myhumankit/ReadForMe/documentation/images/rfm_boitier_test.JPG

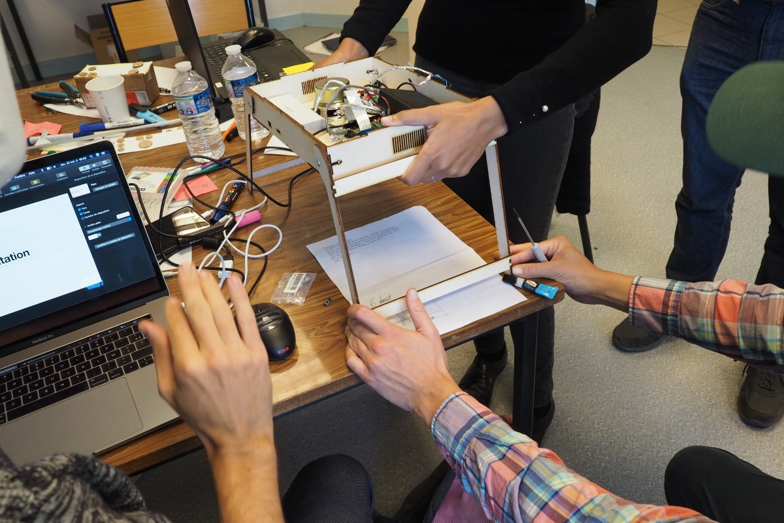
documentation/images/rfm_boitier_test.JPG
