myhumankit/ReadForMe/documentation/images/rfm_proto_carton_test.JPG

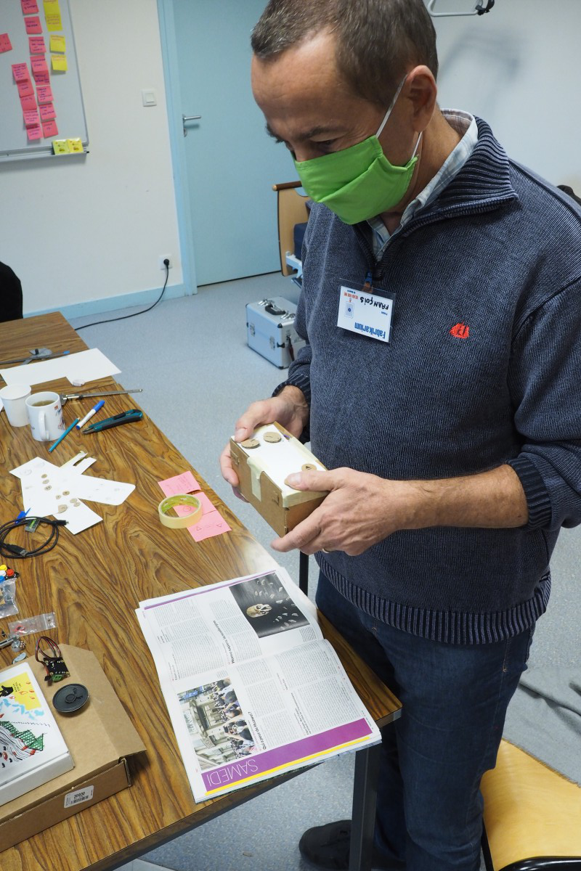
documentation/images/rfm_proto_carton_test.JPG
