myhumankit/ReadForMe/documentation/dessin/images/GPIO_2.png

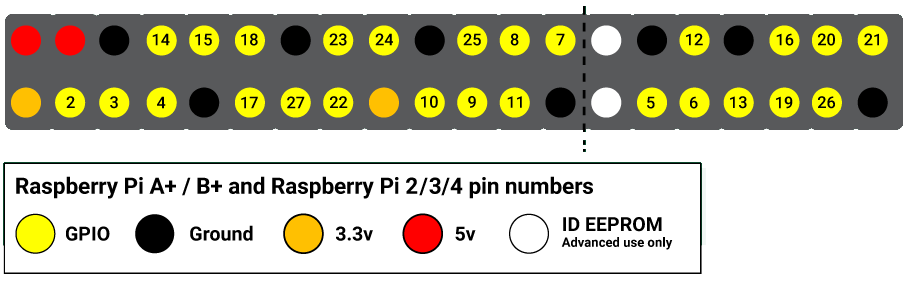
documentation/dessin/images/GPIO_2.png
