myhumankit/ReadForMe/documentation/dessin/images/potentiometer.png

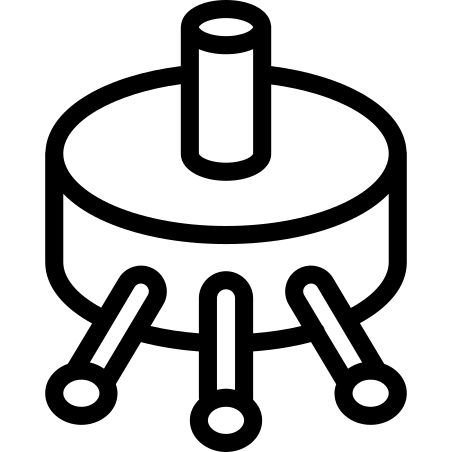
documentation/dessin/images/potentiometer.png
