myhumankit/ReadForMe/documentation/dessin/images/rasp.png

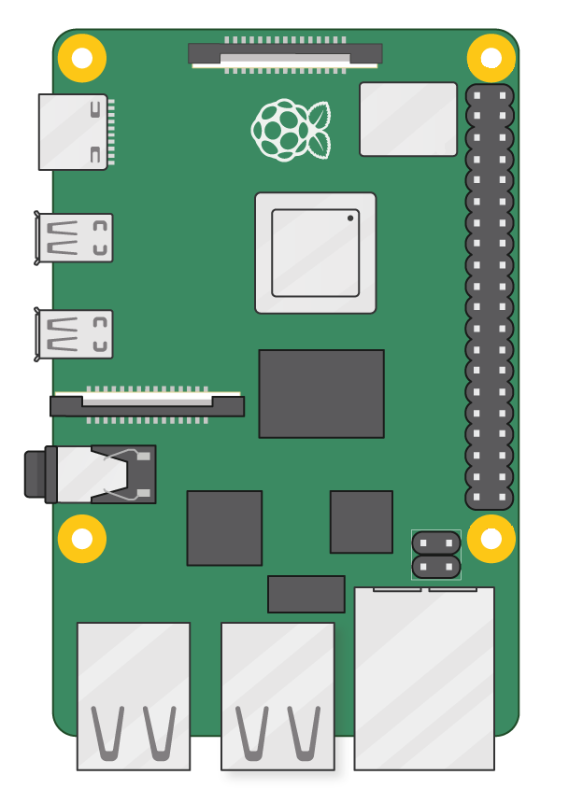
documentation/dessin/images/rasp.png
