myhumankit/ReadForMe/documentation/images/rfm_anim_1.gif

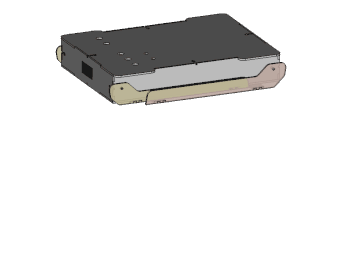
documentation/images/rfm_anim_1.gif
