myhumankit/ReadForMe/documentation/images/rfm_anim_2.gif

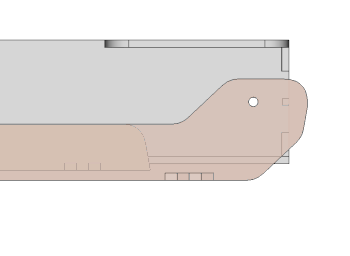
documentation/images/rfm_anim_2.gif
