myhumankit/ReadForMe/documentation/images/rfm_blaze.jpg

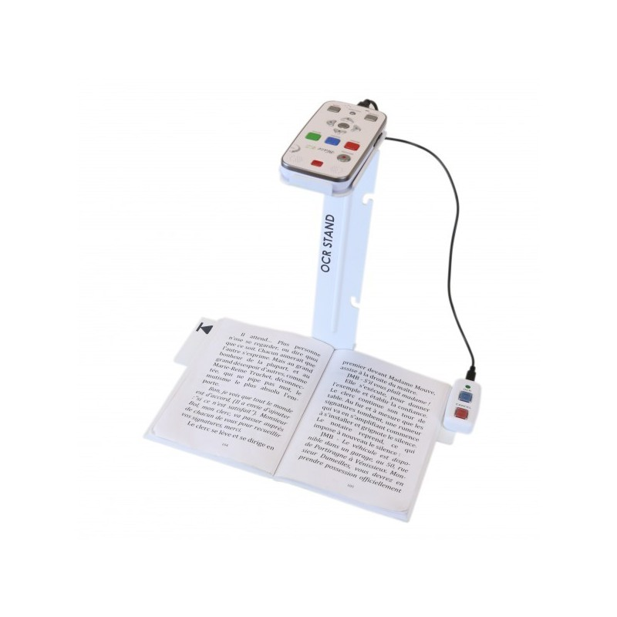
documentation/images/rfm_blaze.jpg
