myhumankit/ReadForMe/documentation/images/rfm_boitier_aluminium.jpg

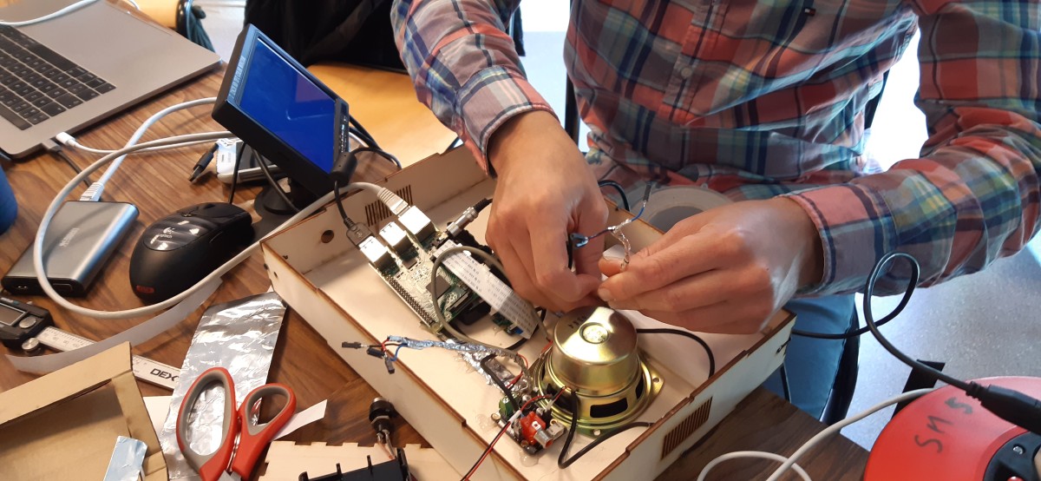
documentation/images/rfm_boitier_aluminium.jpg
