myhumankit/ReadForMe/documentation/images/rfm_boitier_boutons.JPG

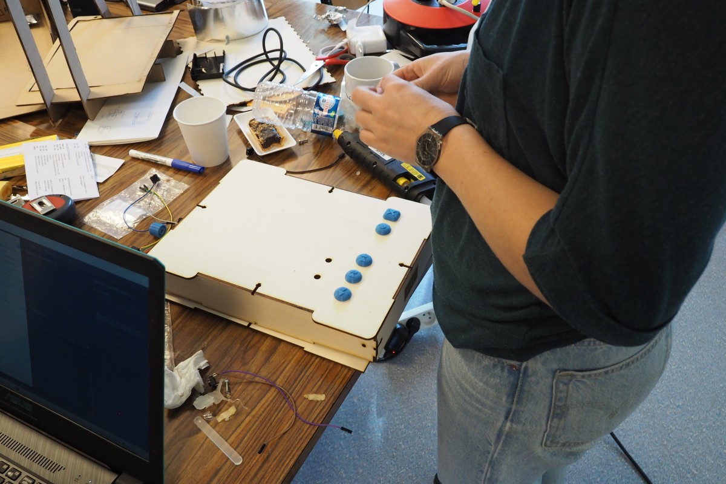
documentation/images/rfm_boitier_boutons.JPG
