myhumankit/ReadForMe/documentation/images/rfm_boitier_colle.JPG

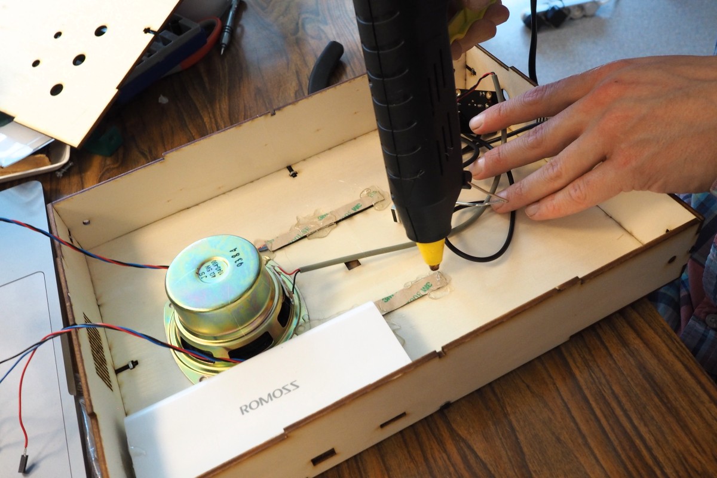
documentation/images/rfm_boitier_colle.JPG
