myhumankit/ReadForMe/documentation/images/rfm_boitier_interieur.JPG

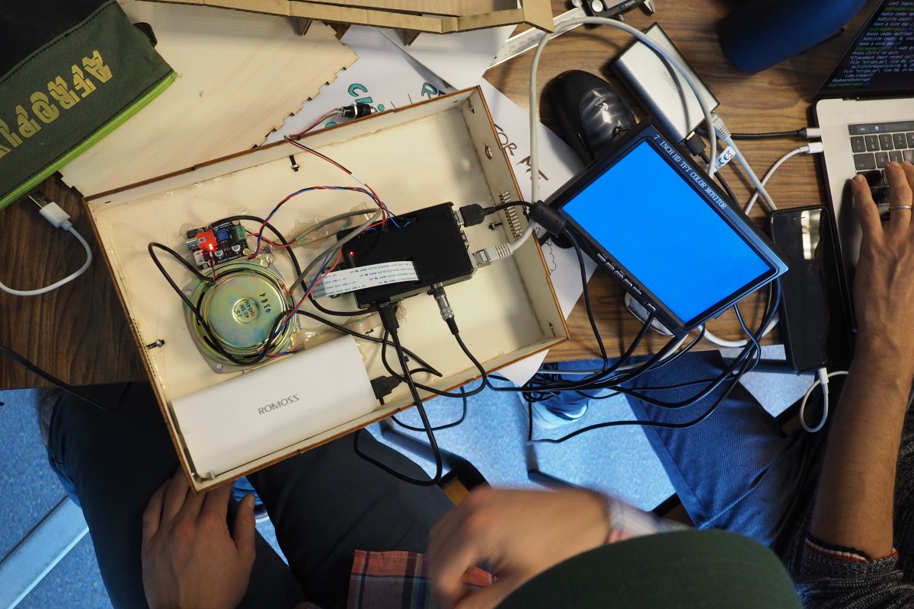
documentation/images/rfm_boitier_interieur.JPG
