myhumankit/ReadForMe/documentation/images/rfm_boutons.png

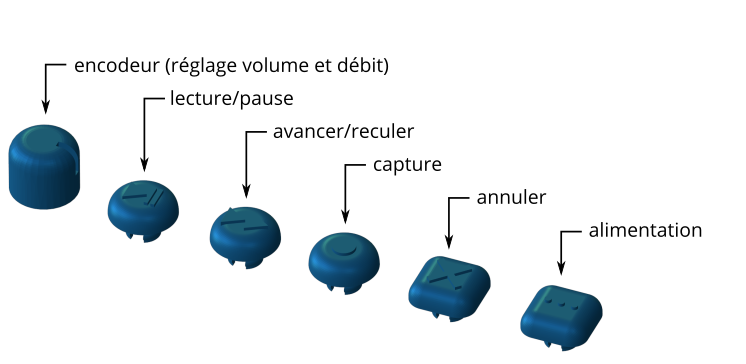
documentation/images/rfm_boutons.png
