myhumankit/ReadForMe/documentation/images/rfm_cablageampli.JPG

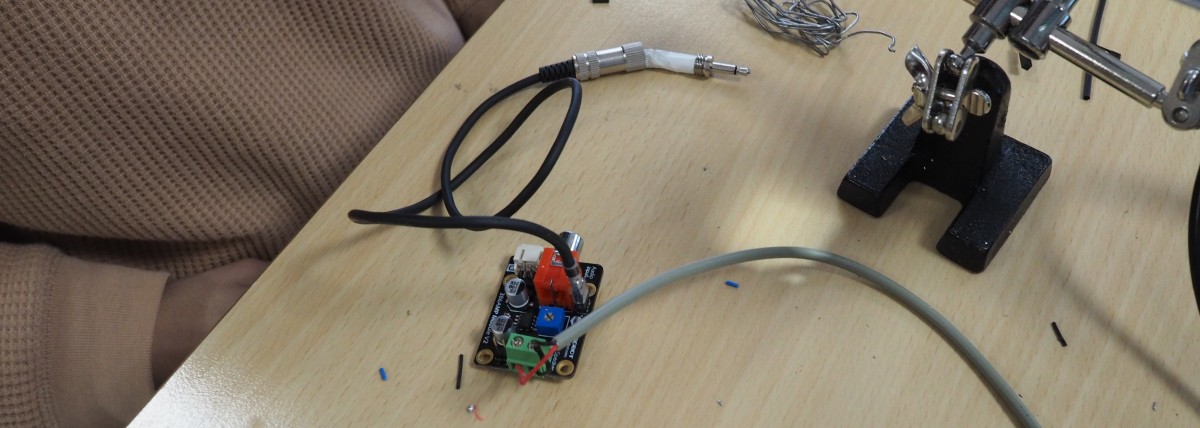
documentation/images/rfm_cablageampli.JPG
