myhumankit/ReadForMe/documentation/images/rfm_circuit.png

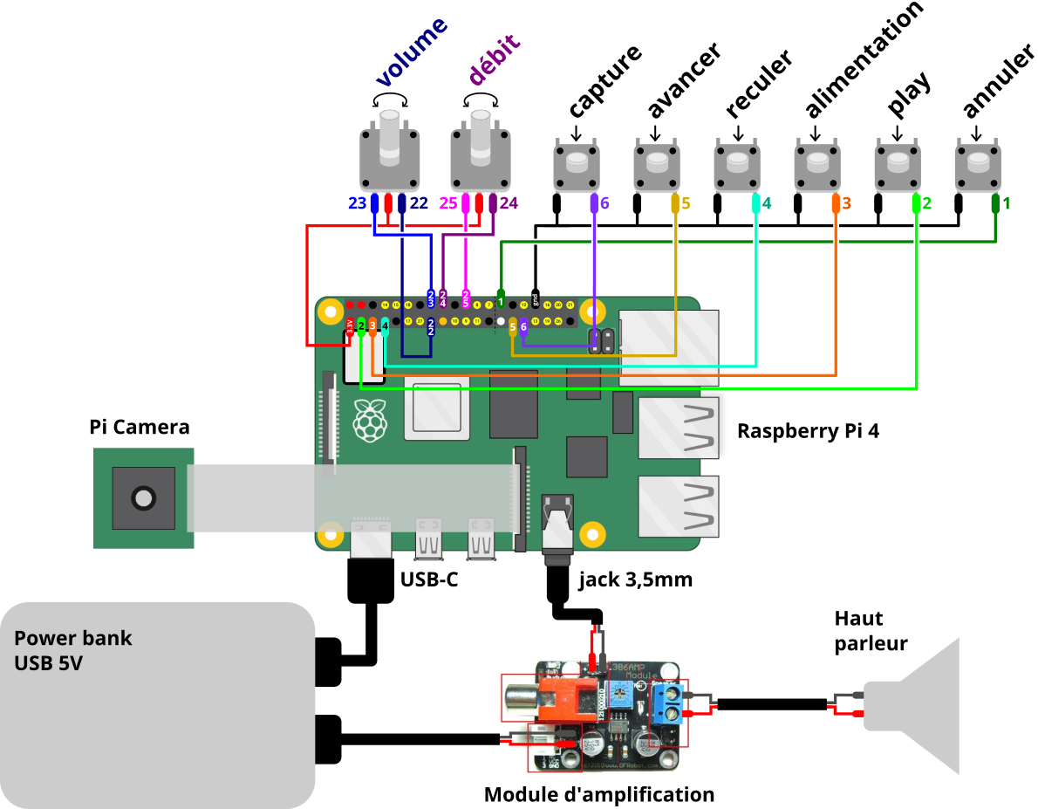
documentation/images/rfm_circuit.png
