myhumankit/ReadForMe/documentation/images/rfm_circuit_pi.JPG

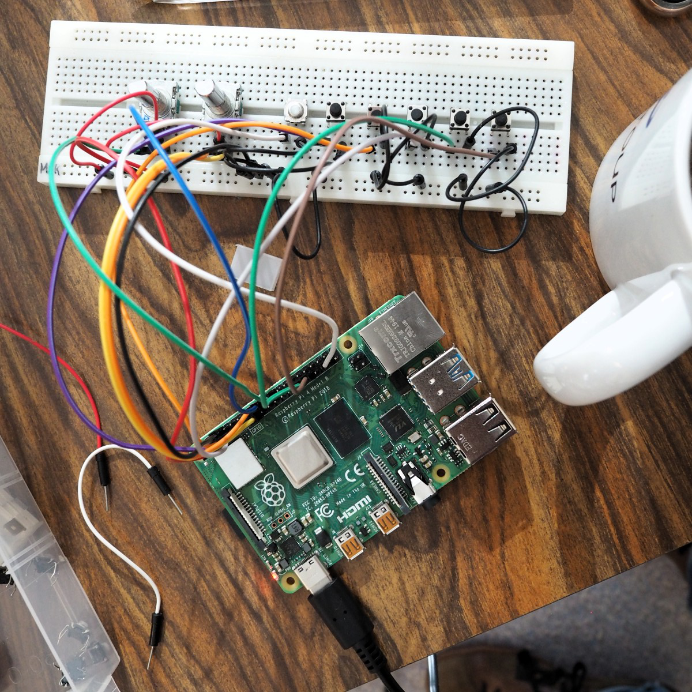
documentation/images/rfm_circuit_pi.JPG
