myhumankit/ReadForMe/documentation/images/rfm_decoupe.png

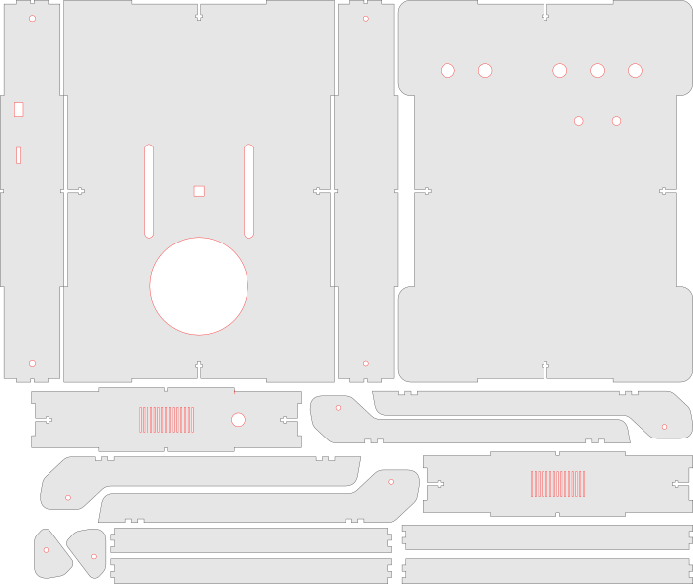
documentation/images/rfm_decoupe.png
