myhumankit/ReadForMe/documentation/images/rfm_design_boutons.JPG

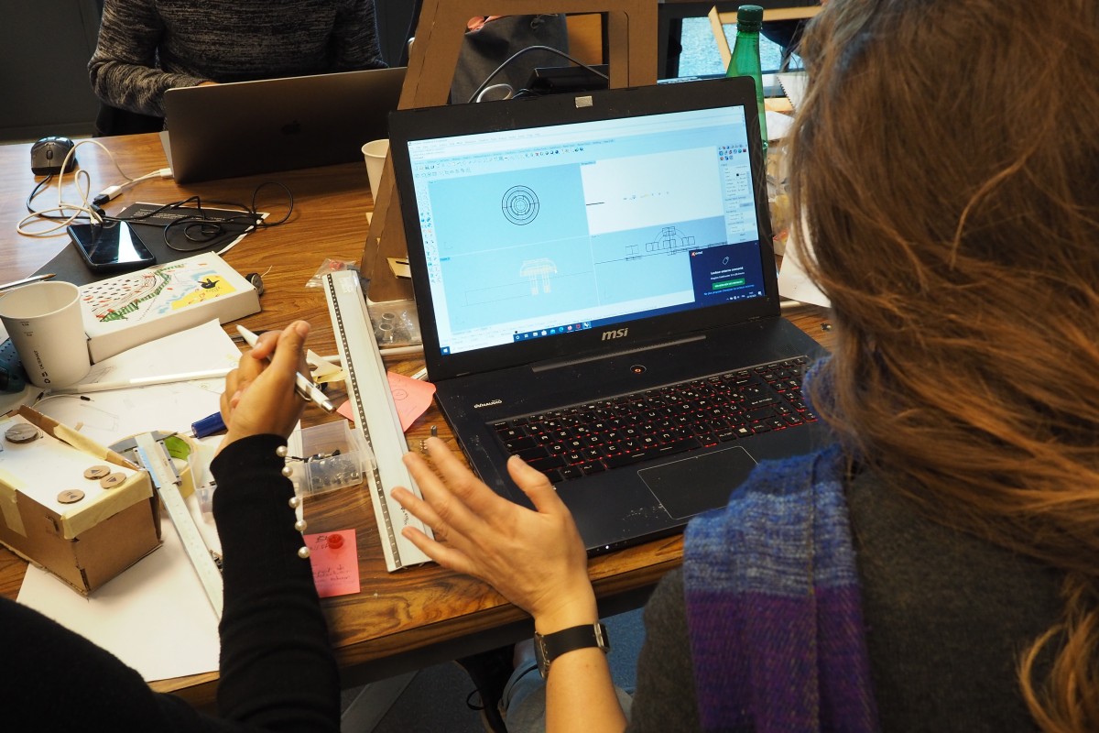
documentation/images/rfm_design_boutons.JPG
