myhumankit/ReadForMe/documentation/images/rfm_equipe0.JPG

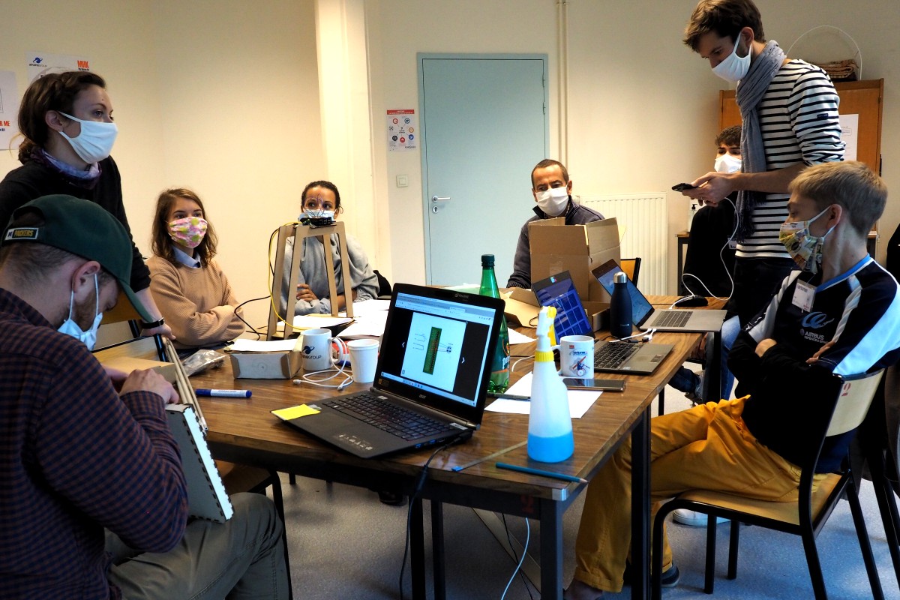
documentation/images/rfm_equipe0.JPG
