myhumankit/ReadForMe/documentation/images/rfm_equipe1.JPG

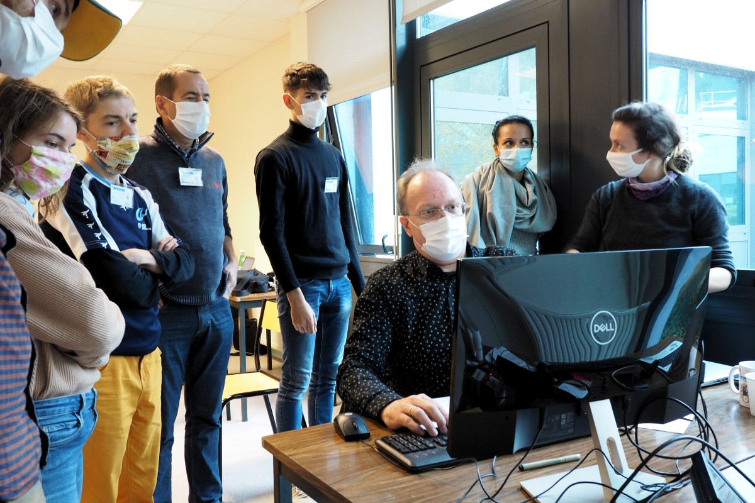
documentation/images/rfm_equipe1.JPG
