myhumankit/ReadForMe/documentation/images/rfm_gpio.png

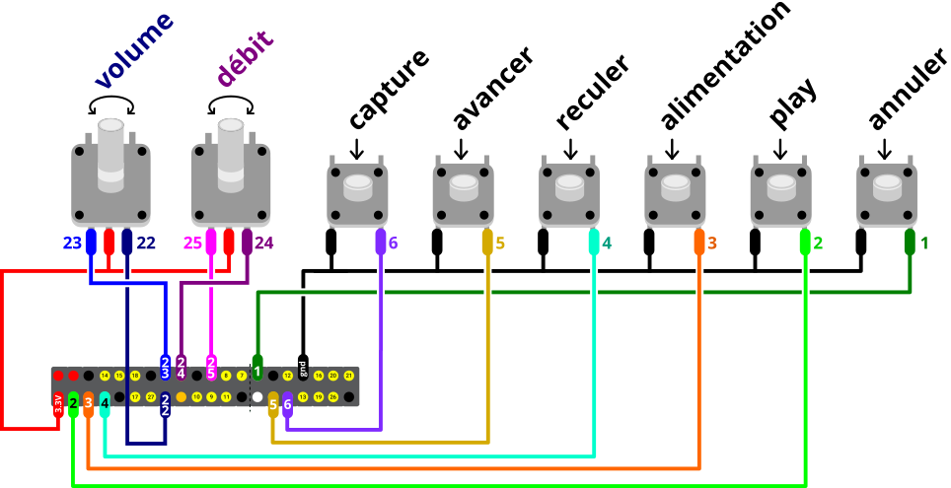
documentation/images/rfm_gpio.png
