myhumankit/ReadForMe/documentation/images/rfm_pitextreader.JPG

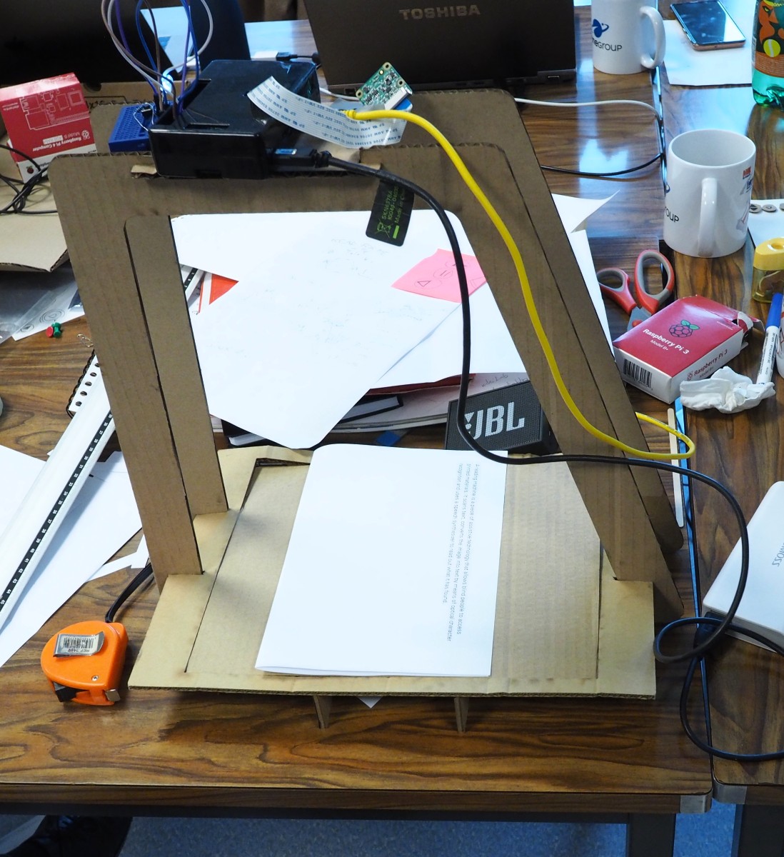
documentation/images/rfm_pitextreader.JPG
