myhumankit/ReadForMe/documentation/images/rfm_polissage.JPG

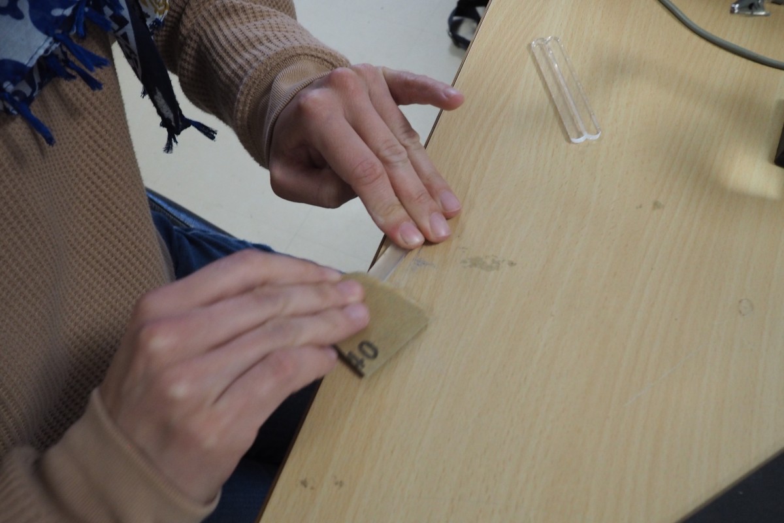
documentation/images/rfm_polissage.JPG
