myhumankit/ReadForMe/documentation/images/rfm_principe_2.png

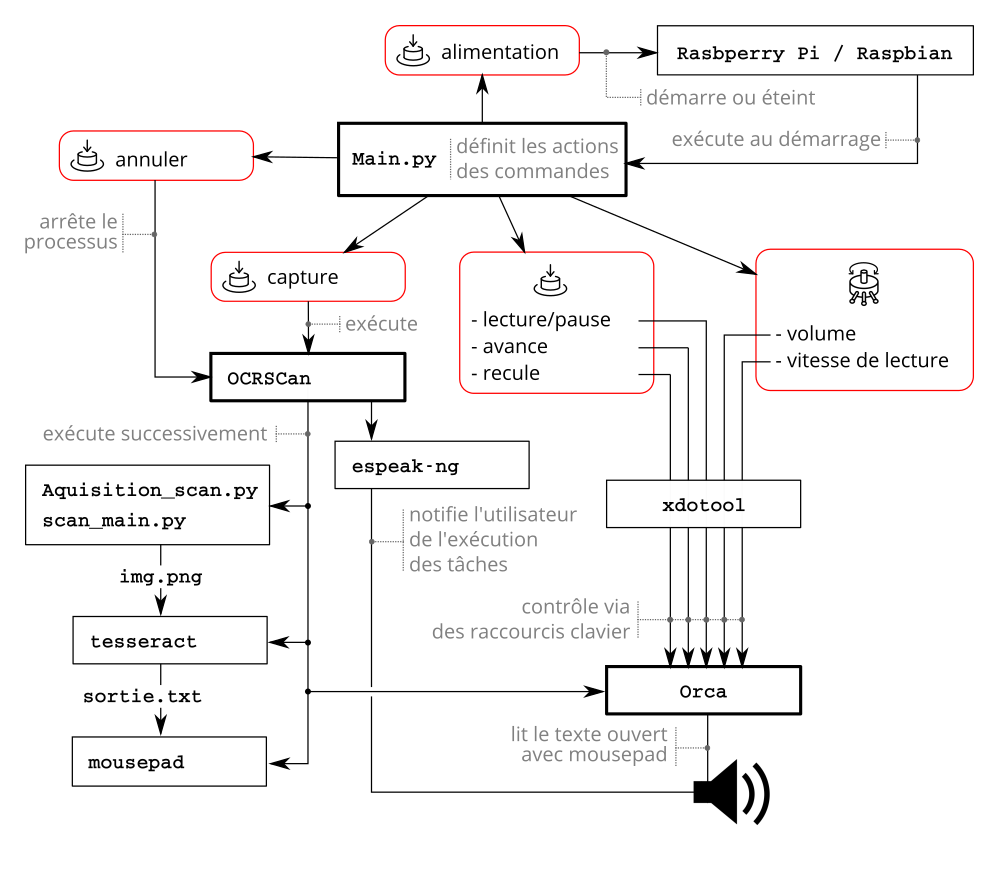
documentation/images/rfm_principe_2.png
