myhumankit/ReadForMe/documentation/images/rfm_proto_carton1.JPG

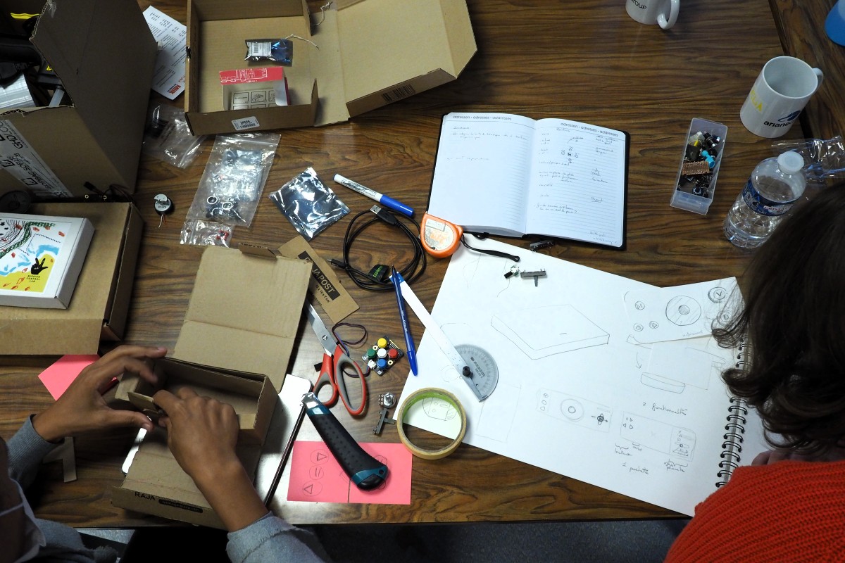
documentation/images/rfm_proto_carton1.JPG
