myhumankit/ReadForMe/documentation/images/rfm_proto_carton2.JPG

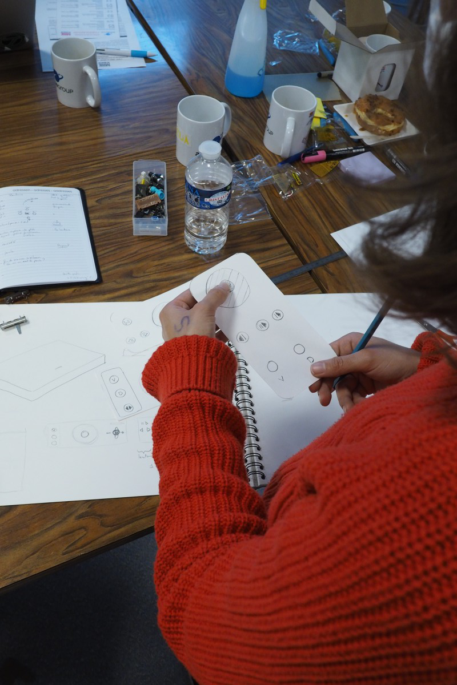
documentation/images/rfm_proto_carton2.JPG
