myhumankit/ReadForMe/documentation/images/rfm_proto_circuit.jpg

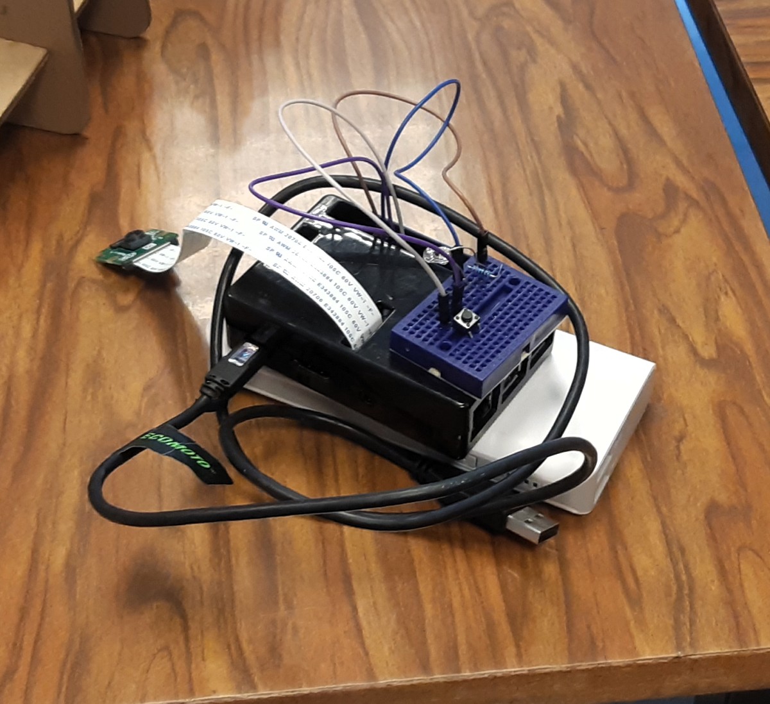
documentation/images/rfm_proto_circuit.jpg
