myhumankit/ReadForMe/documentation/images/rfm_vocatex.jpg

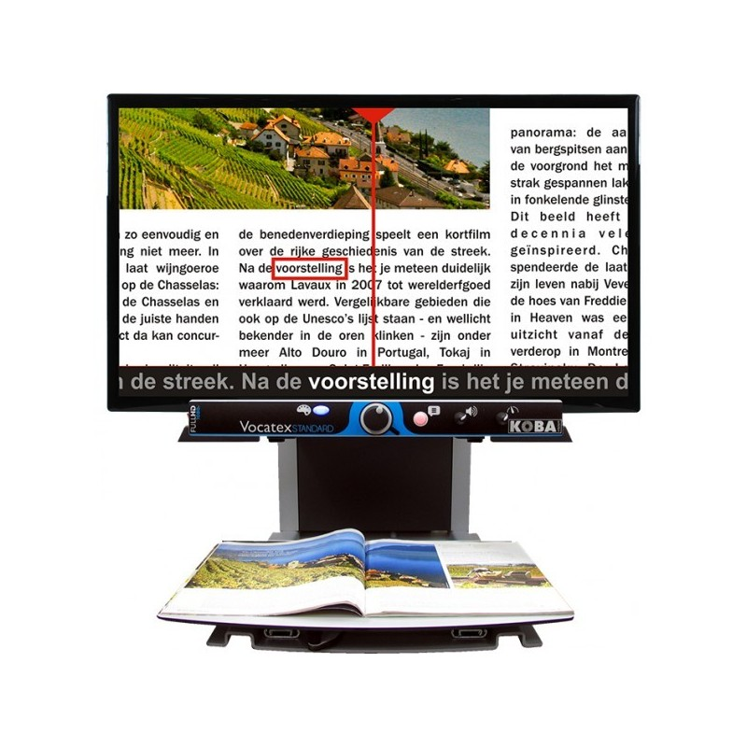
documentation/images/rfm_vocatex.jpg
