myhumankit/ReadForMe/documentation/images/rrm_presentation.JPG

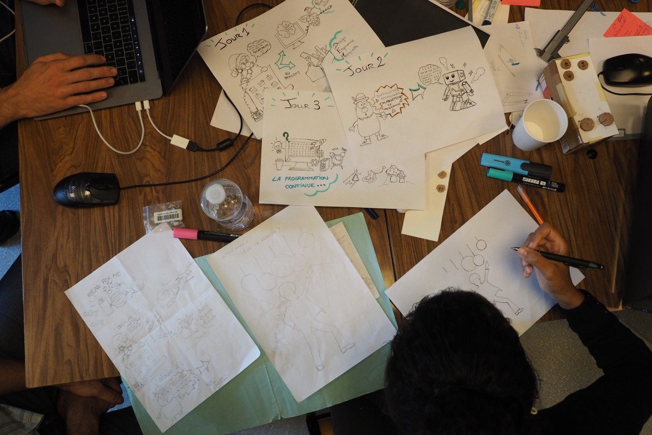
documentation/images/rrm_presentation.JPG
