myhumankit/ReadForMe/modeles/RFM_assemblage.FCStd

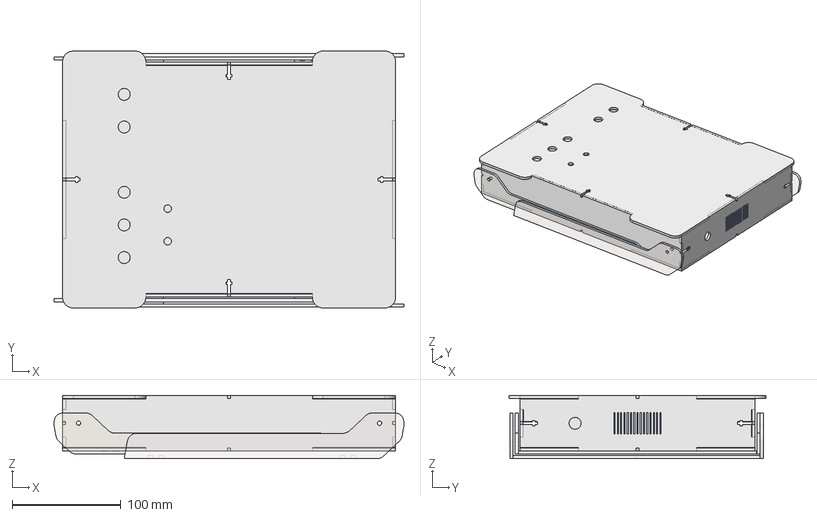
[picture p30: CAD file, 2020-11-18]
modeles/RFM_assemblage.FCStd
321.7 x 236.2 x 58.1 mm
boite
pied1
pied2
