myhumankit/ReadForMe/modeles/orig/3d/bouton5.stl

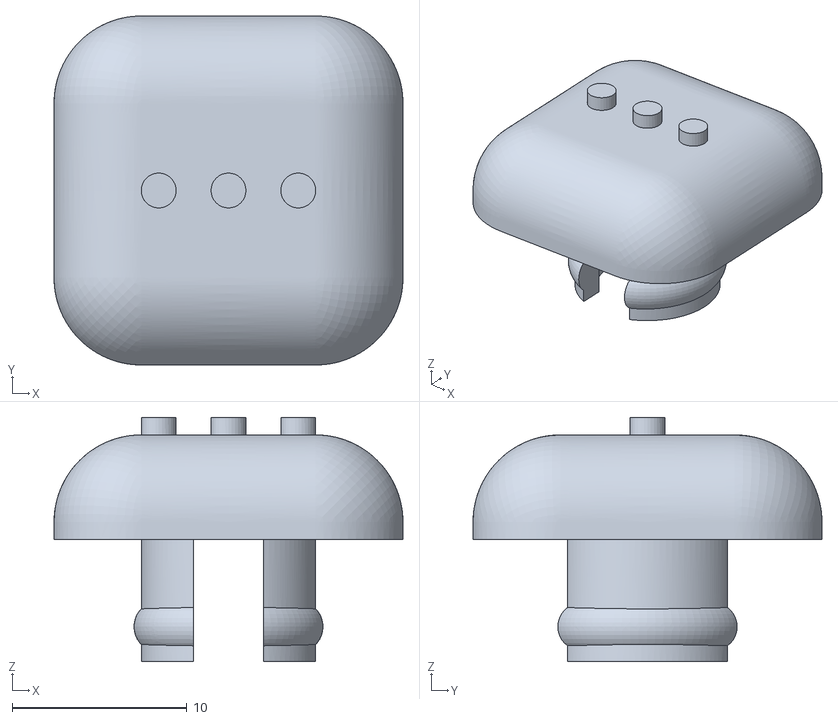
[picture p31: CAD file, 2020-11-18]
modeles/orig/3d/bouton5.stl
20.0 x 20.0 x 14.0
