myhumankit/ReadForMe/modeles/orig/dessin/boitierV3.dxf

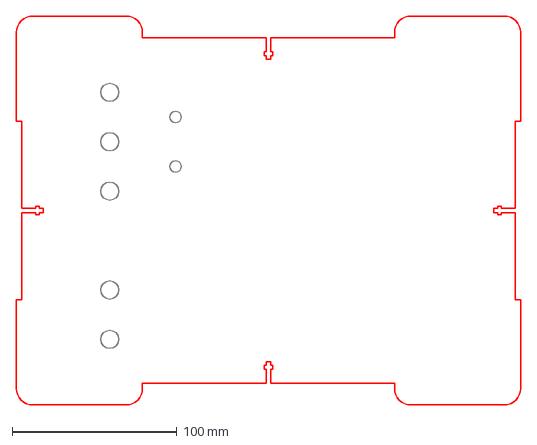
[picture p32: CAD file, 2020-11-18]
modeles/orig/dessin/boitierV3.dxf
306.2 x 236.2 mm
