myhumankit/ReadForMe/modeles/RFM_boutons.FCStd

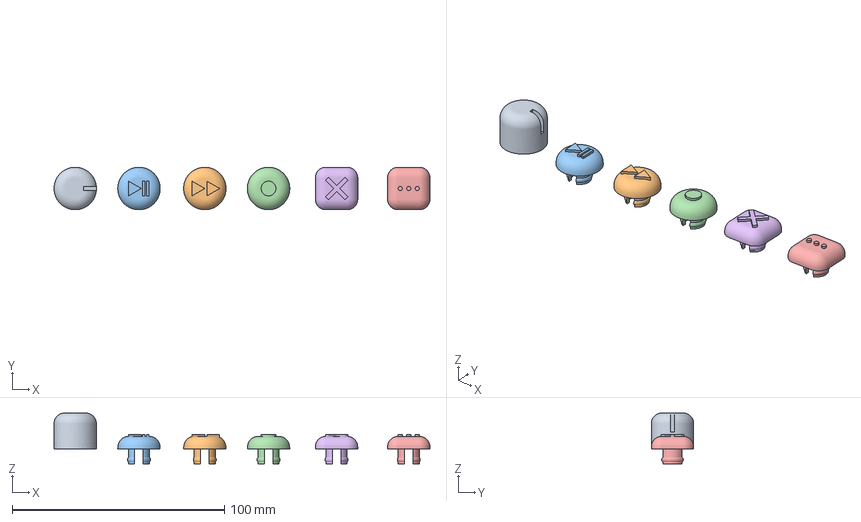
[picture p33: CAD file, 2020-11-18]
modeles/RFM_boutons.FCStd
177.0 x 20.0 x 24.0 mm
Document
bouton1
bouton3
bouton4
bouton5
bouton6
