myhumankit/ReadForMe/modeles/orig/dessin/decoupe pieds rfm.dxf

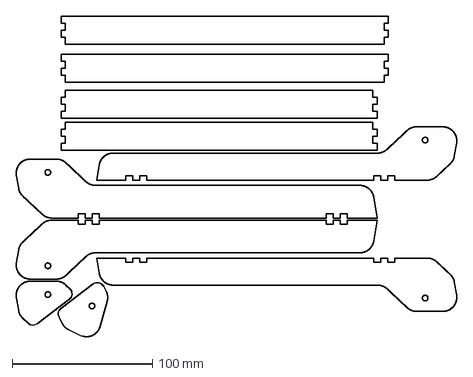
[picture p35: CAD file, 2020-11-18]
modeles/orig/dessin/decoupe pieds rfm.dxf
313.7 x 228.2 mm
