myhumankit/ReadForMe/modeles/orig/3d/bouton3.stl

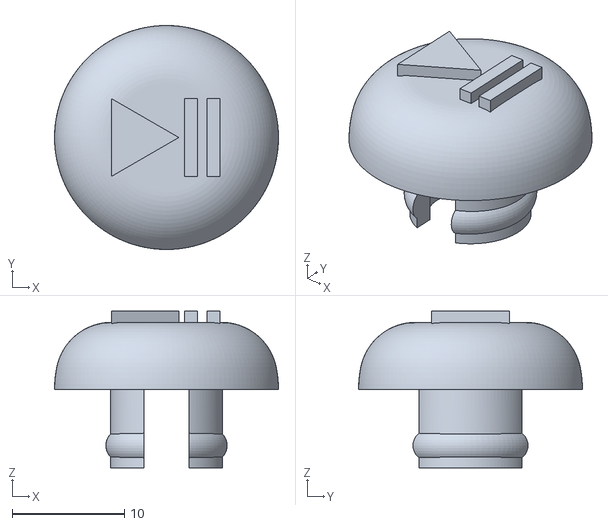
[picture p36: CAD file, 2020-11-18]
modeles/orig/3d/bouton3.stl
20.0 x 20.0 x 14.0
