myhumankit/ReadForMe/modeles/orig/3d/Pivot partie 1.stp

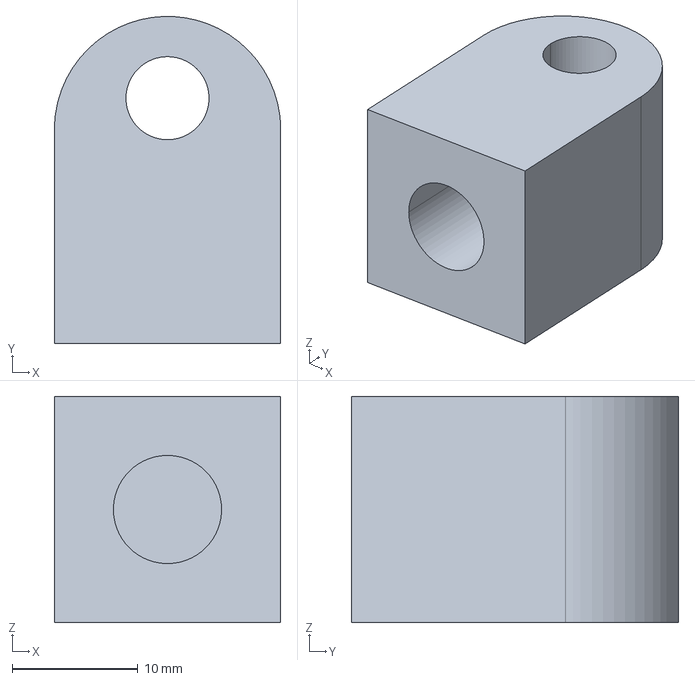
[picture p38: CAD file, 2020-11-18]
modeles/orig/3d/Pivot partie 1.stp
18.0 x 26.0 x 18.0 mm
