myhumankit/ReadForMe/modeles/orig/3d/Clip pour pivot.stp

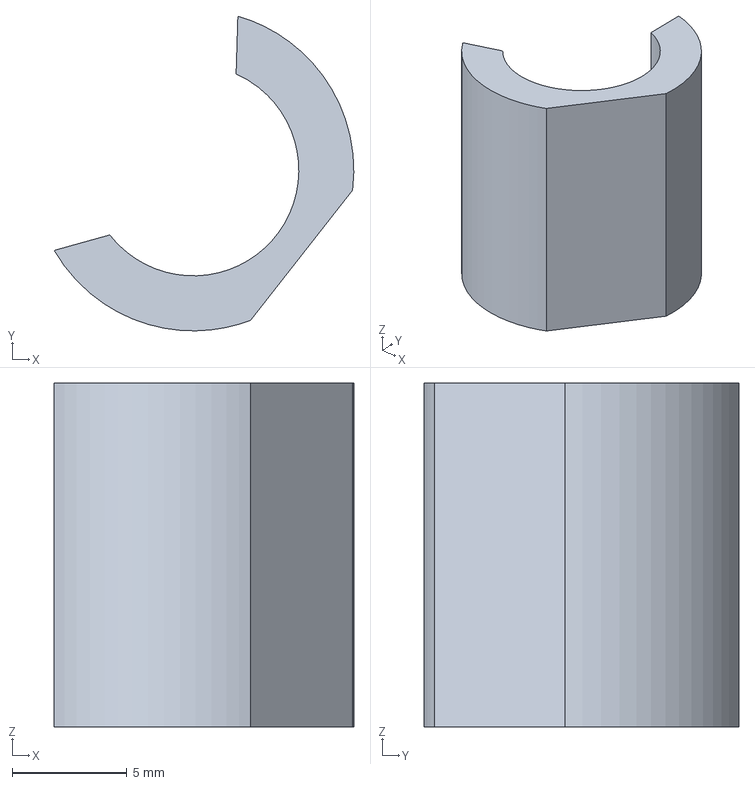
[picture p39: CAD file, 2020-11-18]
modeles/orig/3d/Clip pour pivot.stp
13.1 x 13.7 x 15.0 mm
