myhumankit/ReadForMe/modeles/orig/3d/Pivot partie 2.stp

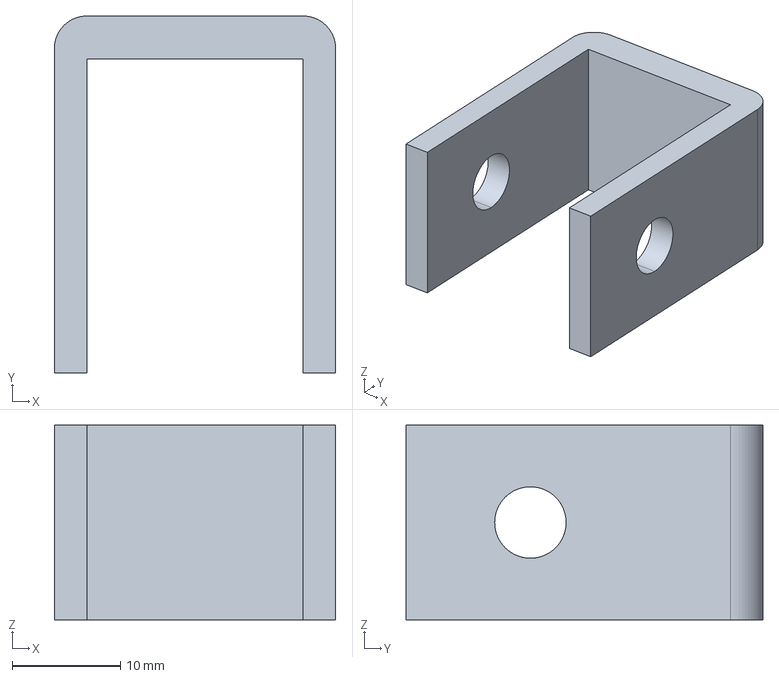
[picture p40: CAD file, 2020-11-18]
modeles/orig/3d/Pivot partie 2.stp
26.0 x 33.0 x 18.0 mm
