myhumankit/ReadForMe/modeles/orig/3d/Bouton potentiomètre.stp

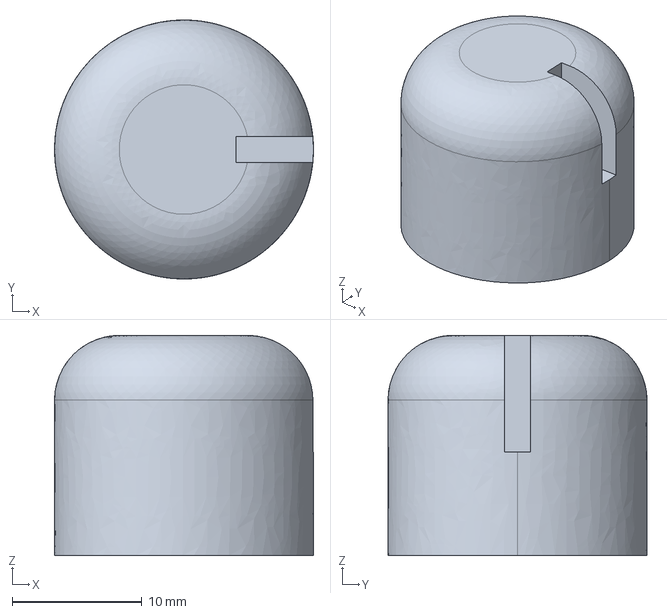
[picture p41: CAD file, 2020-11-18]
modeles/orig/3d/Bouton potentiomètre.stp
20.0 x 20.0 x 17.0 mm
