myhumankit/ReadForMe/(list of files, cad)

Other CAD files:
modeles/orig/3d/bouton1.stl
modeles/orig/3d/bouton2.stl
modeles/RFM_boutons.stl
