myhumankit/ReadForMe/documentation/images/rfm_montage_boitier.JPG

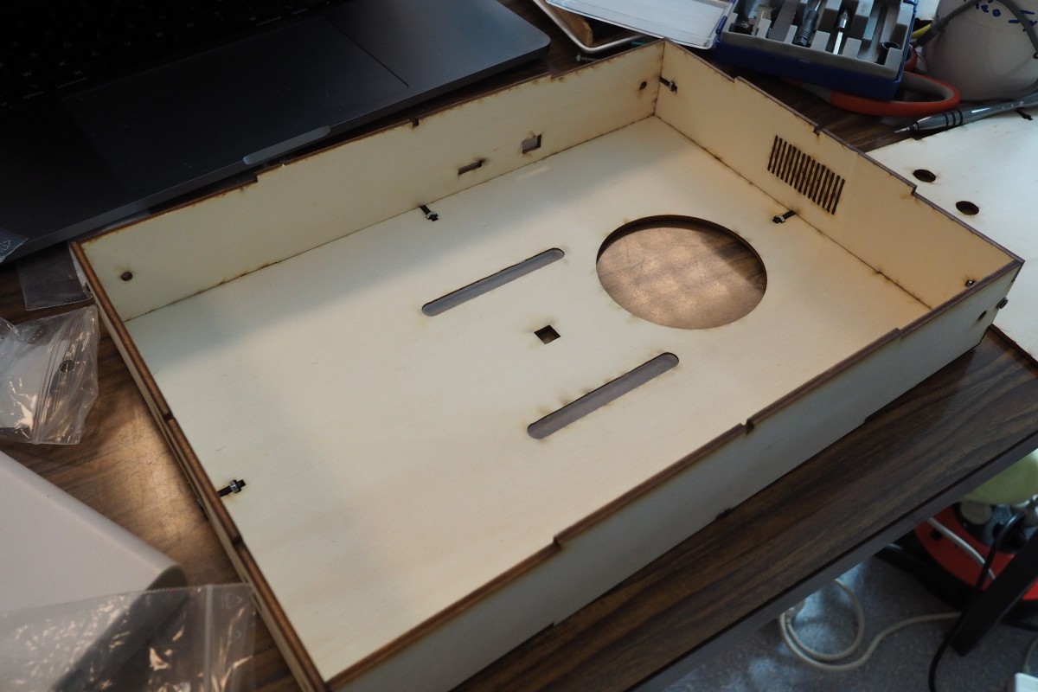
documentation/images/rfm_montage_boitier.JPG
