myhumankit/ReadForMe/documentation/images/rfm_testampli.JPG

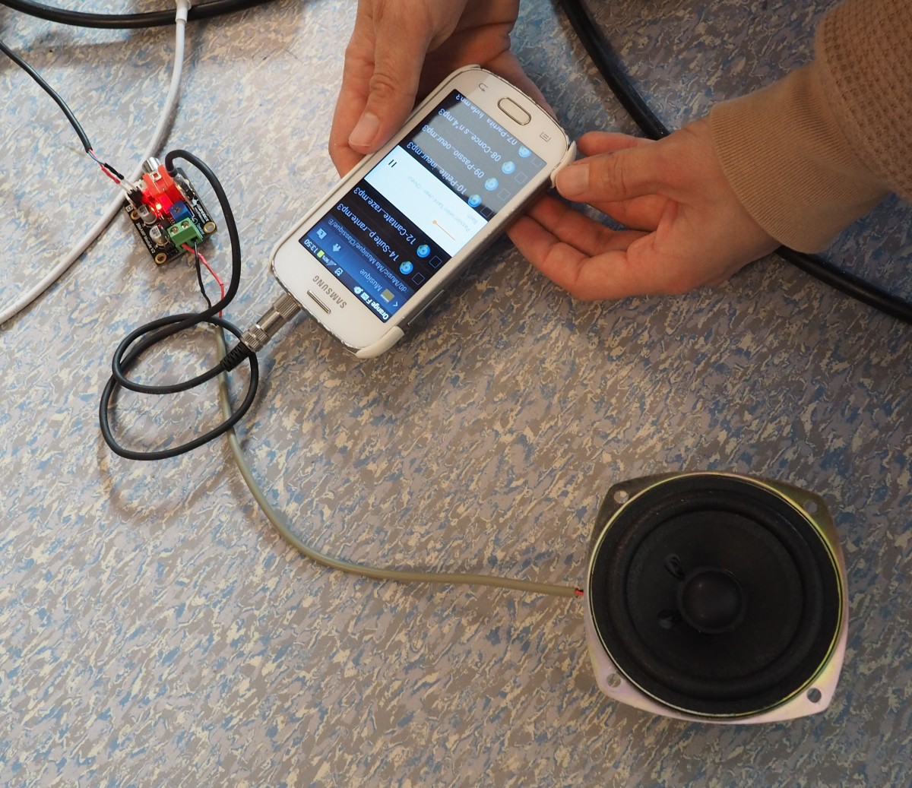
documentation/images/rfm_testampli.JPG
